ariq-dotcom/5dof-robotic-arm/README.md

# Robot Arm 5-DOF

Repository ini berisi file-file hasil Project Based Learning (PBL) pada mata kuliah Otomasi Industri, berupa pengembangan robot arm 5-DOF berbasis Arduino. Project ini mencakup desain assembly mekanikal, desain PCB, perhitungan serta visualisasi menggunakan Python, program kendali servo, dan beberapa dokumentasi pengembangan.

<p align="center">
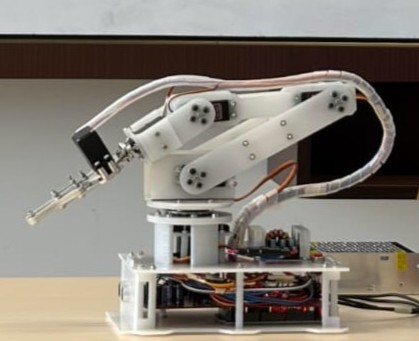
[picture p1: Dokumentasi/4.jpeg]
  
</p>

## File-File
### Mekanikal

desain assembly mekanikal robot arm

### Elektrikal

Perancangan sistem elektrikal, schematic, dan PCB menggunakan KiCad.

### Software

Perangkat lunak untuk perhitungan dan visualisasi invers kinematik robot arm menggunakan Python, serta program Arduino untuk pengendalian servo.

### Dokumentasi

Dokumentasi proses perakitan, perkembangan, dan demonstrasi robot arm.
