ariq-dotcom/5dof-robotic-arm/elektrikal/ARM ELEKTRIKAL.kicad_pcb

## KiCad design elektrikal/ARM ELEKTRIKAL.kicad_pcb (2026-08-11)

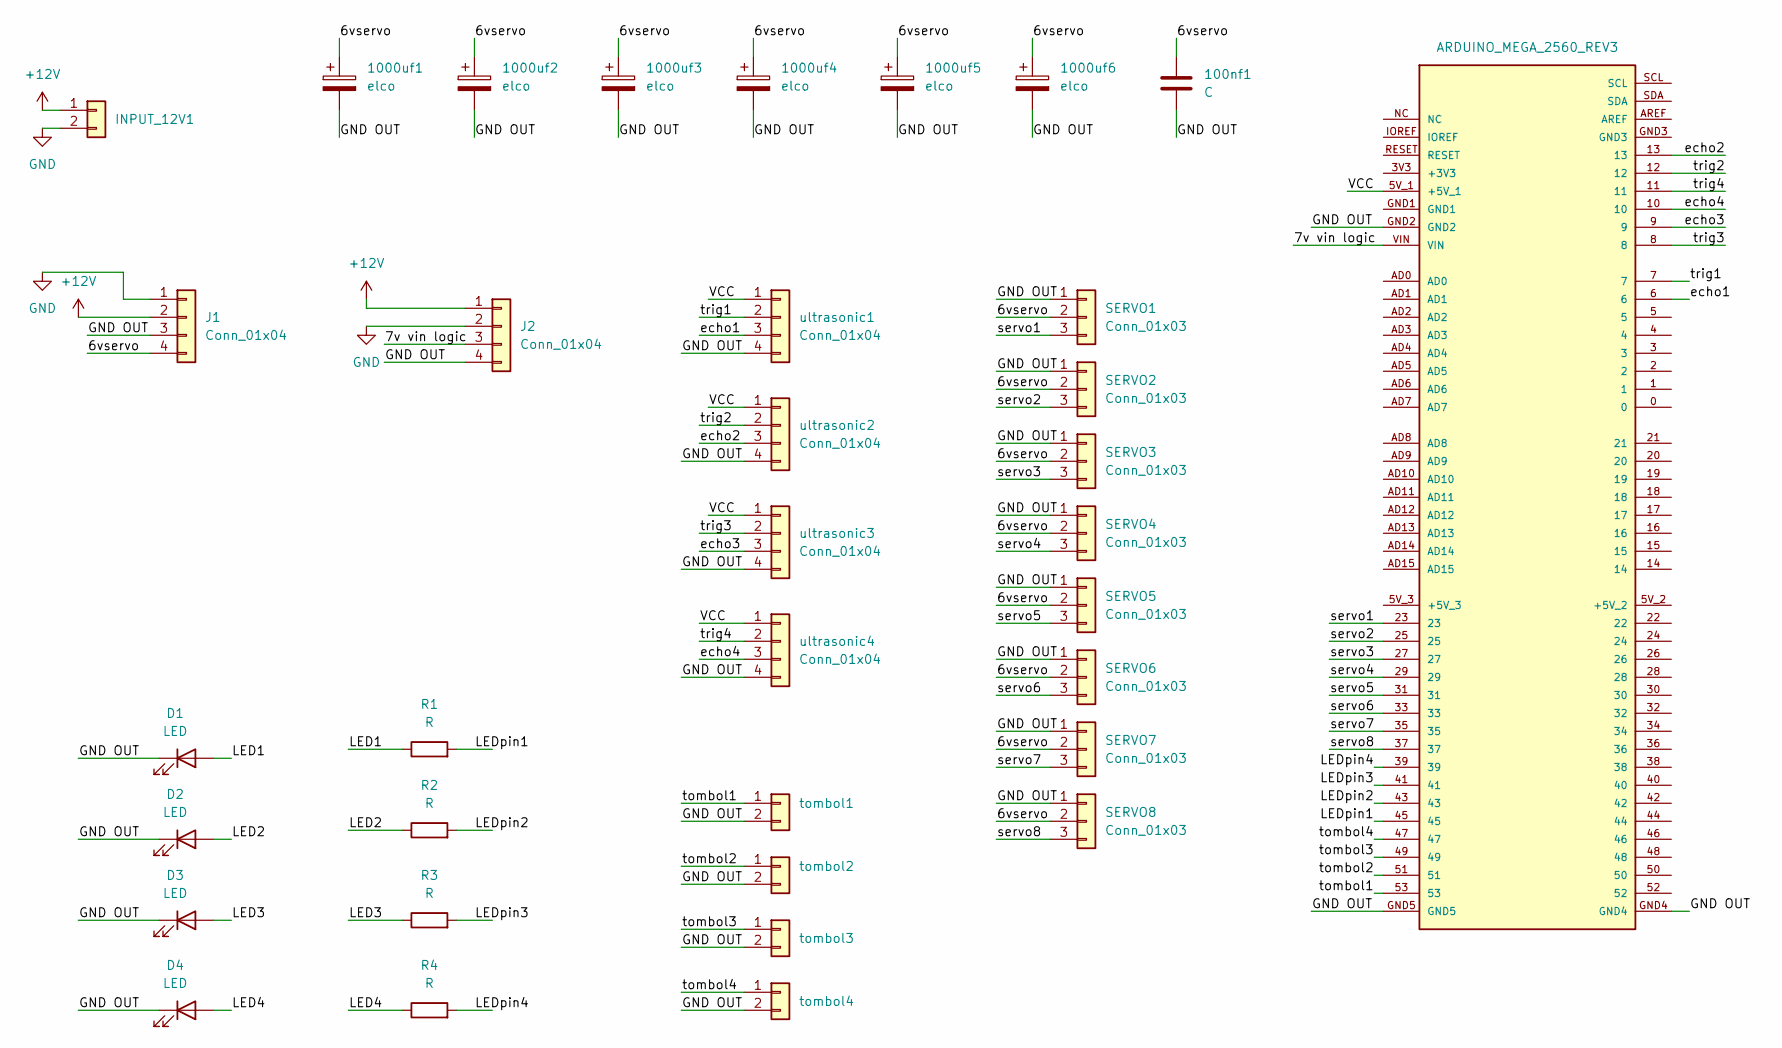
[picture p2: schematic ARM ELEKTRIKAL.kicad_sch]

Parts:
100nf1: C; C_Rect_L9.0mm_W2.7mm_P7.50mm_MKT
1000uf1, 1000uf2, 1000uf3, 1000uf4, 1000uf5, 1000uf6: elco; CP_Radial_D10.0mm_P5.00mm
A1: ARDUINO_MEGA_2560_REV3; ARDUINO_ARDUINO_MEGA_2560_REV3; PARTREV 3
D1, D2, D3, D4: LED; PinHeader_1x02_P2.54mm_Vertical
INPUT_12V1: Conn_01x02; TerminalBlock_MetzConnect_Type171_RT13702HBWC_1x02_P7.50mm_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
J1, J2: Conn_01x04; TerminalBlock_MetzConnect_Type171_RT13704HBWC_1x04_P7.50mm_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
R1, R2, R3, R4: R; R_Axial_DIN0204_L3.6mm_D1.6mm_P7.62mm_Horizontal
SERVO1, SERVO2, SERVO3, SERVO4, SERVO5, SERVO6, SERVO7, SERVO8: Conn_01x03; PinHeader_1x03_P2.54mm_Vertical
tombol1, tombol2, tombol3, tombol4: Conn_01x02; PinHeader_1x02_P2.54mm_Vertical
ultrasonic1, ultrasonic2, ultrasonic3, ultrasonic4: Conn_01x04; PinHeader_1x04_P2.54mm_Vertical

Connections:
+12V: INPUT_12V1.1, J1.2, J2.1
/6vservo: 100nf1.1, 1000uf1.1, 1000uf2.1, 1000uf3.1, 1000uf4.1, 1000uf5.1, 1000uf6.1, J1.4, SERVO1.2, SERVO2.2, SERVO3.2, SERVO4.2, SERVO5.2, SERVO6.2, SERVO7.2, SERVO8.2
/7v vin logic: A1.VIN, J2.3
/GND OUT: 100nf1.2, 1000uf1.2, 1000uf2.2, 1000uf3.2, 1000uf4.2, 1000uf5.2, 1000uf6.2, A1.GND2, A1.GND4, A1.GND5, D1.1 (K), D2.1 (K), D3.1 (K), D4.1 (K), J1.3, J2.4, SERVO1.1, SERVO2.1, SERVO3.1, SERVO4.1, SERVO5.1, SERVO6.1, SERVO7.1, SERVO8.1, tombol1.2, tombol2.2, tombol3.2, tombol4.2, ultrasonic1.4, ultrasonic2.4, ultrasonic3.4, ultrasonic4.4
/LED1: D1.2 (A), R1.1
/LED2: D2.2 (A), R2.1
/LED3: D3.2 (A), R3.1
/LED4: D4.2 (A), R4.1
/LEDpin1: A1.45, R1.2
/LEDpin2: A1.43, R2.2
/LEDpin3: A1.41, R3.2
/LEDpin4: A1.39, R4.2
/VCC: A1.5V_1 (+5V_1), ultrasonic1.1, ultrasonic2.1, ultrasonic3.1, ultrasonic4.1
/echo1: A1.6, ultrasonic1.3
/echo2: A1.13, ultrasonic2.3
/echo3: A1.9, ultrasonic3.3
/echo4: A1.10, ultrasonic4.3
/servo1: A1.23, SERVO1.3
/servo2: A1.25, SERVO2.3
/servo3: A1.27, SERVO3.3
/servo4: A1.29, SERVO4.3
/servo5: A1.31, SERVO5.3
/servo6: A1.33, SERVO6.3
/servo7: A1.35, SERVO7.3
/servo8: A1.37, SERVO8.3
/tombol1: A1.53, tombol1.1
/tombol2: A1.51, tombol2.1
/tombol3: A1.49, tombol3.1
/tombol4: A1.47, tombol4.1
/trig1: A1.7, ultrasonic1.2
/trig2: A1.12, ultrasonic2.2
/trig3: A1.8, ultrasonic3.2
/trig4: A1.11, ultrasonic4.2
GND: INPUT_12V1.2, J1.1, J2.2

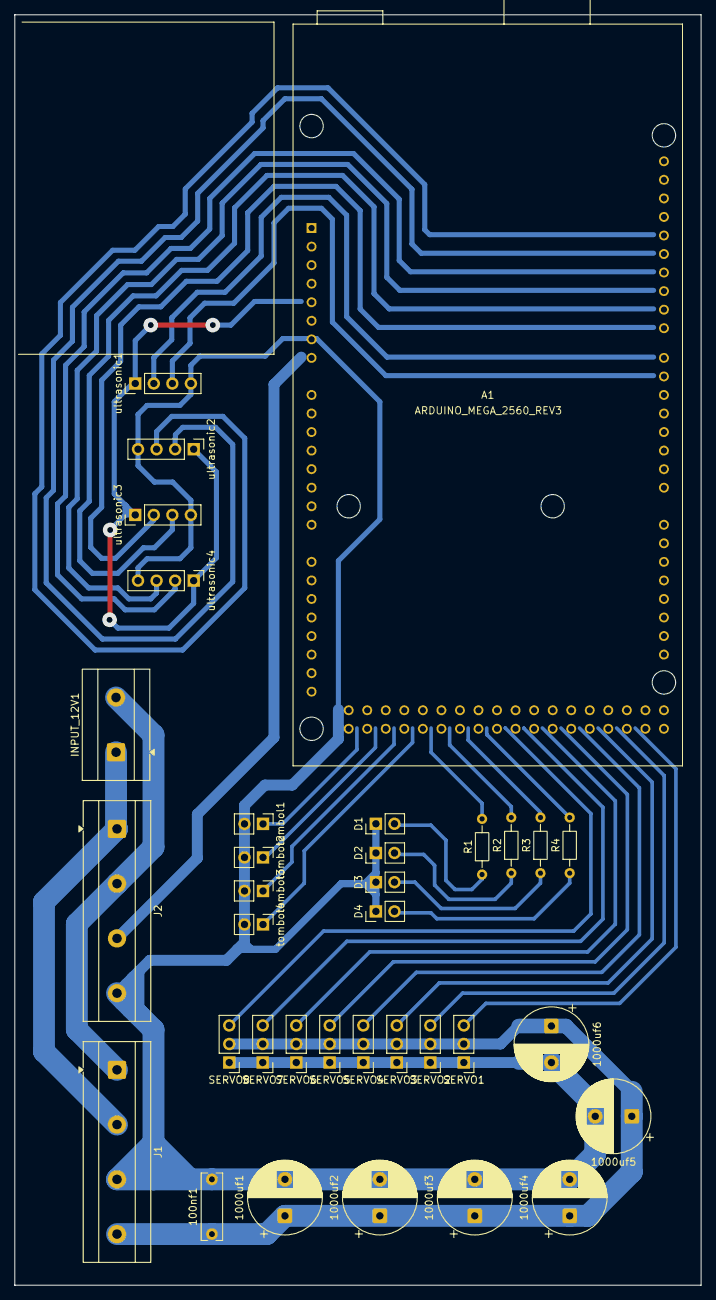
[picture p3: board ARM ELEKTRIKAL.kicad_pcb from above]

Board: 2 copper layers, 94.0 x 174.0 mm, 35 parts (0 on the bottom side), 34 nets.
