ariq-dotcom/5dof-robotic-arm/mekanikal/ASSEMBLY.png

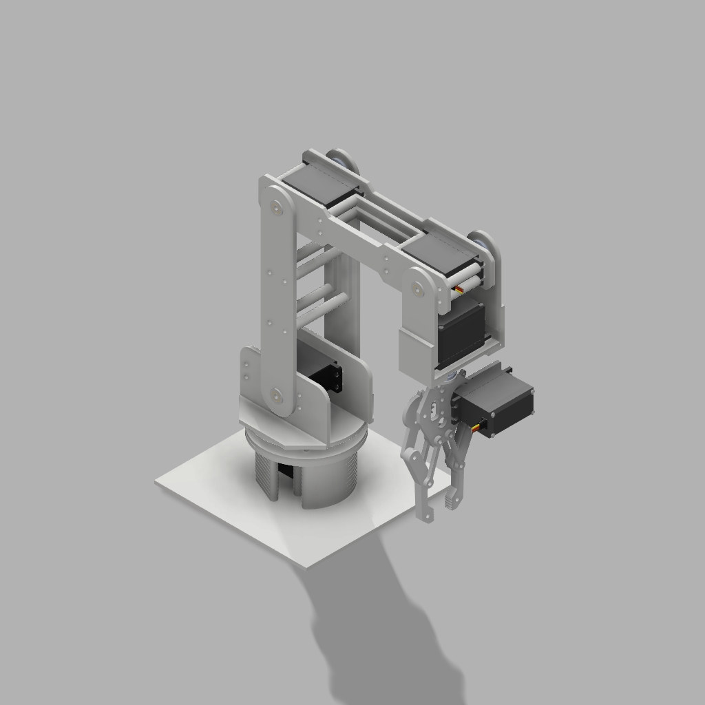
mekanikal/ASSEMBLY.png
