ariq-dotcom/5dof-robotic-arm/software/kendali/kendali.ino

//KELOMPOK 2 projek robot

// Ariq Suryaselpha Hamid
// Sofyan Adam Malik
// Noviana Rahmadhani
// Gilang Al Buqhori
// Wahyu Septian Wicahya


#include <Arduino.h>
#include <Servo.h>

#define pinHOME 53 // posisi awal
#define pinKERJA 51 // mode kerja
#define pinDEMO 49 // mode demonstrasi (beberapa gerakan kemampuan robot)

#define ledHOME 4
#define ledKERJA 3
#define ledDEMO 2

#define TRIG_PIN 12
#define ECHO_PIN 13

enum Mode {
  HOME,
  KERJA,
  DEMO
};

Mode modeSekarang = HOME;
Mode modeDiminta = HOME;

bool tugasSelesai = true;

//===============================================================================
//===============================================================================
//===============================================================================

//nama servo
Servo base;
Servo shoulder;
Servo elbow;
Servo wristP;
Servo wristR;
Servo gripper;

#include <math.h>
//dimensi robot
const float L1 = 7.9;
const float L2 = 15.0;
const float L3 = 13.0;
const float L4 = 7.3;
const float L5 = 11;

//untuk nilai sekarang juga penyimpanan nilai saat berjalan
float sekarang_s0 = 90;
float sekarang_s1 = 20;
float sekarang_s2 = 20;
float sekarang_s3 = 117;
float sekarang_s4 = 90;

//nilai sudut untuk ke posisi home
const float HOME_s0 = 90;
const float HOME_s1 = 20;
const float HOME_s2 = 20;
const float HOME_s3 = 117;
const float HOME_s4 = 90;

// ===== PROTOTIPE FUNGSI =====
bool ik_task(float x, float y, float z_target, float phi_deg,
                      float *t0_deg, float *t1_deg, float *t2_deg, 
                      float *t3_deg, float *t4_deg);

float keServo(float sudut);

void mapkeServo(float t0, float t1, float t2, float t3, float t4,
                float *s0, float *s1, float *s2, float *s3, float *s4);

void gerakKe(float x, float y, float z, float phi, int stepDelay);

void gerakServo(float s0, float s1, float s2,
                float s3, float s4, int stepDelay);

void bacaTombol();

void updateLED();

void gerakHome();

float bacaJarak();

bool tunggu(unsigned long waktu);

//MMMMMMMMMMMMMMMMMMMMMMMMMMMMMMMMMMMMMMMMMMMMMMMMMMMMMMMMMMMMMMMM
//MMMMMMMMMMMMMMMMMMMMMMMMMMMMMMMMMMMMMMMMMMMMMMMMMMMMMMMMMMMMMMMM
void setup() {
  Serial.begin(115200);

  pinMode(pinHOME, INPUT_PULLUP);
  pinMode(pinKERJA, INPUT_PULLUP);
  pinMode(pinDEMO, INPUT_PULLUP);

  pinMode(TRIG_PIN, OUTPUT);
  pinMode(ECHO_PIN, INPUT);

  pinMode(ledHOME, OUTPUT);
  pinMode(ledKERJA, OUTPUT);
  pinMode(ledDEMO, OUTPUT);

  base.attach(23);
  shoulder.attach(31);
  elbow.attach(29);
  wristP.attach(35);
  wristR.attach(33);
  gripper.attach(25);

  base.write((int)sekarang_s0);
  shoulder.write((int)sekarang_s1);
  elbow.write((int)sekarang_s2);
  wristP.write((int)sekarang_s3);
  wristR.write((int)sekarang_s4);

  // ===== CETAK KE SERIAL (untuk monitor) =====
    Serial.print("Base: "); Serial.print((int)sekarang_s0);
    Serial.print(" | Shoulder: "); Serial.print((int)sekarang_s1);
    Serial.print(" | Elbow: "); Serial.print((int)sekarang_s2);
    Serial.print(" | WristP: "); Serial.print((int)sekarang_s3);
    Serial.print(" | WristR: "); Serial.println((int)sekarang_s4);

  delay(5000);
  updateLED();
}
//MMMMMMMMMMMMMMMMMMMMMMMMMMMMMMMMMMMMMMMMMMMMMMMMMMMMMMMMMMMMMMMM
//MMMMMMMMMMMMMMMMMMMMMMMMMMMMMMMMMMMMMMMMMMMMMMMMMMMMMMMMMMMMMMMM

//################################################################
//################################################################
void loop() {

  bacaTombol();

  // Menjalankan mode yang aktif
  switch (modeSekarang) {

//############################
//========== HOME ===========
    case HOME: {
      // Program home
      if (sekarang_s0 != HOME_s0 ||
      sekarang_s1 != HOME_s1 ||
      sekarang_s2 != HOME_s2 ||
      sekarang_s3 != HOME_s3 ||
      sekarang_s4 != HOME_s4) {
      tugasSelesai = false;
      if (!tunggu(100))
    break;
      gripper.write(95);
      gerakHome();
      tugasSelesai = true;
      }
      break;
    }
//============================
//############################
//========== KERJA ===========

    case KERJA: {
      // Program kerja
      tugasSelesai = false;

      float jarak = bacaJarak();

      if (!tunggu(100))
    break;
  
      // x,y,z,phi,delayStep
      gerakKe(-0.7, 10, 0, -90, 7);
      Serial.print("Jarak: ");
      Serial.print(jarak);
      Serial.println(" cm");
      if (jarak > 0 && jarak < 13) {
        Serial.println("Objek Terdeteksi");
        gripper.write(25);

        jarak = bacaJarak();
        Serial.println(jarak);
        if (!tunggu(1000))
      break;
        jarak = bacaJarak();
        Serial.println(jarak);
        if (!tunggu(1000))
      break;
        jarak = bacaJarak();
        Serial.println(jarak);
        if (!tunggu(1000))
      break;

        //+8 cm adalah jarak awal persis depan sensor, 
        //dihitung dari titik pusat invers kinematik ke sensor
        //lalu + setelahnya untuk offset seberapa panjang lebar objek yang diambil
        //menyesuaikan agar posisi capitan pas
        
        gerakKe(-0.7, 8+jarak +1, 0, -90, 7);
        if (!tunggu(1000))
      break;
        gerakKe(-0.7, 8+jarak +1, -5, -90, 7);
        if (!tunggu(1000))
      break;
        gripper.write(95);
        if (!tunggu(1000))
      break;
        gerakKe(-0.7, 8+jarak +1, 0, -90, 7);
        if (!tunggu(1000))
      break;

      // ==== lanjutan ====
        gerakKe(-13, 0, 0, -90, 7);
        if (!tunggu(1000))
      break;
        gerakKe(-13, 0, -5, -90, 7);
        if (!tunggu(1000))
      break;
        gripper.write(25);
        if (!tunggu(2000))
      break;
        gerakKe(-13, 7, -5, -90, 10);
        if (!tunggu(500))
      break;

      }

      tugasSelesai = true;
      break;
    }
//============================
//############################
//========== DEMO ===========
    case DEMO: {
      // Program demo
      tugasSelesai = false;

      // x,y,z,phi,delayStep
      gerakKe(0, 15, 0, -90, 7);
      if (!tunggu(2000))
    break;
      gripper.write(25);
      if (!tunggu(1000))
    break;
      gerakKe(0, 15, 0, -90, 7);
      if (!tunggu(1000))
    break;
      gerakKe(0, 15, -5, -90, 7);
      gripper.write(95);
      if (!tunggu(1000))
    break;

      gerakKe(0, 15, 0, -90, 7);
      if (!tunggu(1000))
    break;
      gerakKe(15, 0, 0, -90, 7);
      if (!tunggu(1000))
    break;
      gerakKe(15, 0, -5, -90, 7);
      if (!tunggu(1000))
    break;
      gripper.write(25);
      if (!tunggu(1000))
    break;
      gripper.write(95);
      if (!tunggu(1000))
    break;
      gerakKe(15, 0, 0, -90, 7);
      if (!tunggu(1000))
    break;

      gerakKe(-15, 0, 0, -90, 7);
      if (!tunggu(1000))
    break;
      gerakKe(-15, 0, -5, -90, 7);
      if (!tunggu(1000))
    break;
      gripper.write(25);
      if (!tunggu(1000))
    break;
      gripper.write(95);
      if (!tunggu(1000))
    break;
      gerakKe(-15, 0, 0, -90, 7);
      if (!tunggu(1000))
    break;

      tugasSelesai = true;
      break;
    }
  }
//============================
//############################

    if (tugasSelesai && modeDiminta != modeSekarang) {
      modeSekarang = modeDiminta;
      updateLED();
      Serial.print("Pindah ke mode : ");

      switch (modeSekarang) {

        case HOME:
          Serial.println("HOME");
          break;

        case KERJA:
          Serial.println("KERJA");
          break;

        case DEMO:
          Serial.println("DEMO");
          break;
      }
    }
}
//################################################################
//################################################################

//################################################################
// FUNGSI IK, FUNGSI IK, FUNGSI IK
//################################################################

// ==== FUNGSI IK ====
bool ik_task(float x, float y, float z_target, float phi_deg,
                      float *t0_deg, float *t1_deg, float *t2_deg, 
                      float *t3_deg, float *t4_deg) {
  
  // ===== Base rotation =====
  float theta0 = atan2(y, x);
  float theta0_deg = theta0 * 180.0 / PI;
  
  // ===== Wrist rotation =====
  // menjaga agar gripper menyesuaikan arah base
  float theta4_deg = theta0_deg;
  
  // ===== Transformasi ke plane =====
  float x_plane_tcp = x * cos(theta0) + y * sin(theta0);
  float y_plane_tcp = z_target - L1;

  // ===== Tool offset =====
  float L_tool = L4 + L5;
  float phi = phi_deg * PI / 180.0;  // konversi ke radian
  
  float x_plane = x_plane_tcp - L_tool * cos(phi);
  float y_plane = y_plane_tcp - L_tool * sin(phi);
  
  // ===== Jarak ke shoulder =====
  float r = sqrt(x_plane * x_plane + y_plane * y_plane);

  // ===== Cek workspace =====
  if (r > (L2 + L3) || r < fabs(L2 - L3))
  {
    Serial.print("Target di luar workspace : ");
    Serial.print(x);
    Serial.print(", ");
    Serial.print(y);
    Serial.print(", ");
    Serial.println(z_target);  

    return false;
  }
  
  // ===== Elbow-up solution =====
  float cos_theta2 = (x_plane*x_plane + y_plane*y_plane - L2*L2 - L3*L3) / (2.0 * L2 * L3);
  cos_theta2 = constrain(cos_theta2, -1.0, 1.0);
  float theta2 = -acos(cos_theta2);
  
  float k1 = L2 + L3 * cos(theta2);
  float k2 = L3 * sin(theta2);

  float theta1 = atan2(y_plane, x_plane) - atan2(k2, k1);
  
  // ===== Wrist pitch =====
  float theta3 = phi - (theta1 + theta2);
  
  // ===== Konversi ke derajat =====
  float theta1_deg = theta1 * 180.0 / PI;
  float theta2_deg = theta2 * 180.0 / PI;
  float theta3_deg = theta3 * 180.0 / PI;

  // ===== KEMBALIKAN HASIL via pointer =====
  *t0_deg = theta0_deg;
  *t1_deg = theta1_deg;
  *t2_deg = theta2_deg;
  *t3_deg = theta3_deg;
  *t4_deg = theta4_deg;

  return true;
}
//################################################################
//################################################################

//MMMMMMMMMMMMMMMMMMMMMMMMMMMMMMMMMMMMMMMMMMMMMMMMMMMMMMMMMMMMMMMM
// FUNGSI MAPPING DAN CLAMP
//MMMMMMMMMMMMMMMMMMMMMMMMMMMMMMMMMMMMMMMMMMMMMMMMMMMMMMMMMMMMMMMM

//==== CLAMP ====
float keServo(float sudut) {
  if (sudut < 0) return 0;
  if (sudut > 180) return 180;
  return sudut;
}

//==== MAPPING ====
void mapkeServo(float t0, float t1, float t2, float t3, float t4,
                float *s0, float *s1, float *s2, float *s3, float *s4) {
  // =======================================
  // KOREKSI MEKANIK (Hasil perhitungan matematis disesuaikan 
  // dengan kalibrasi pemasangan servo)
  // =======================================
  *s0 = t0;
  *s1 = 180 - t1;
  *s2 = t2 + 180;
  *s3 = 180 - (t3 + 90);
  *s4 = t4;
  // ============
  // CLAMP 0–180
  // ============
  *s0 = keServo(*s0);
  *s1 = keServo(*s1);
  *s2 = keServo(*s2);
  *s3 = keServo(*s3);
  *s4 = keServo(*s4);
}
//MMMMMMMMMMMMMMMMMMMMMMMMMMMMMMMMMMMMMMMMMMMMMMMMMMMMMMMMMMMMMMMM
//MMMMMMMMMMMMMMMMMMMMMMMMMMMMMMMMMMMMMMMMMMMMMMMMMMMMMMMMMMMMMMMM

//################################################################
//FUNGSI GERAKAN HALUS
//################################################################
void gerakKe(float x, float y, float z, float phi, int stepDelay) {

  // ===== TARGET IK =====
  float t0, t1, t2, t3, t4;

  // ===== TARGET SERVO =====
  float s0, s1, s2, s3, s4;

  // ===== IK =====
  if (!ik_task(x, y, z, phi,
          &t0, &t1, &t2, &t3, &t4))
  {
    return;
  }

  // ===== MAPPING =====
  mapkeServo(t0, t1, t2, t3, t4,
             &s0, &s1, &s2, &s3, &s4);

  gerakServo(s0, s1, s2, s3, s4, stepDelay);
}
//################################################################
//################################################################

//################################################################
// FUNGSI BACA TOMBOL
//################################################################
void bacaTombol() {

  static unsigned long lastDebounce = 0;

  if (millis() - lastDebounce < 200)
    return;

  if (digitalRead(pinHOME) == LOW &&
      modeSekarang != HOME) {

    modeDiminta = HOME;
    Serial.println("Mode HOME diminta");
    lastDebounce = millis();
  }

  else if (digitalRead(pinKERJA) == LOW &&
           modeSekarang != KERJA) {

    modeDiminta = KERJA;
    Serial.println("Mode KERJA diminta");
    lastDebounce = millis();
  }

  else if (digitalRead(pinDEMO) == LOW &&
           modeSekarang != DEMO) {

    modeDiminta = DEMO;
    Serial.println("Mode DEMO diminta");
    lastDebounce = millis();
  }
}
//################################################################
//################################################################

//################################################################
// FUNGSI GERAK, LINEAR INTERPOLATION
//################################################################
void gerakServo(float s0, float s1, float s2,
                float s3, float s4, int stepDelay)
{
  float start_s0 = sekarang_s0;
  float start_s1 = sekarang_s1;
  float start_s2 = sekarang_s2;
  float start_s3 = sekarang_s3;
  float start_s4 = sekarang_s4;

  float d0 = fabs(s0 - start_s0);
  float d1 = fabs(s1 - start_s1);
  float d2 = fabs(s2 - start_s2);
  float d3 = fabs(s3 - start_s3);
  float d4 = fabs(s4 - start_s4);

  float maxDelta = d0;

  if (d1 > maxDelta) maxDelta = d1;
  if (d2 > maxDelta) maxDelta = d2;
  if (d3 > maxDelta) maxDelta = d3;
  if (d4 > maxDelta) maxDelta = d4;

  int steps = (int)maxDelta;

  if (steps < 1)
    steps = 1;

  for (int i = 1; i <= steps; i++) {

    float p = (float) i / steps;

    sekarang_s0 = start_s0 + (s0 - start_s0) * p;
    sekarang_s1 = start_s1 + (s1 - start_s1) * p;
    sekarang_s2 = start_s2 + (s2 - start_s2) * p;
    sekarang_s3 = start_s3 + (s3 - start_s3) * p;
    sekarang_s4 = start_s4 + (s4 - start_s4) * p;
    
    bacaTombol();

    if (modeDiminta != modeSekarang)
        return;
      
    base.write((int)sekarang_s0);
    shoulder.write((int)sekarang_s1);
    elbow.write((int)sekarang_s2);
    wristP.write((int)sekarang_s3);
    wristR.write((int)sekarang_s4);

    Serial.print("Base: "); Serial.print((int)sekarang_s0);
    Serial.print(" | Shoulder: "); Serial.print((int)sekarang_s1);
    Serial.print(" | Elbow: "); Serial.print((int)sekarang_s2);
    Serial.print(" | WristP: "); Serial.print((int)sekarang_s3);
    Serial.print(" | WristR: "); Serial.println((int)sekarang_s4);

    delay(stepDelay);
  }

  sekarang_s0 = s0;
  sekarang_s1 = s1;
  sekarang_s2 = s2;
  sekarang_s3 = s3;
  sekarang_s4 = s4;
}
//################################################################
//################################################################

//################################################################
// FUNGSI UPDATE LED
//################################################################
void updateLED() {

  digitalWrite(ledHOME, modeSekarang == HOME);
  digitalWrite(ledKERJA, modeSekarang == KERJA);
  digitalWrite(ledDEMO, modeSekarang == DEMO);
}
//################################################################
//################################################################

//################################################################
// FUNGSI KEMBALI KE POSISI HOME
//################################################################
void gerakHome()
{
    gerakServo(
        HOME_s0,
        HOME_s1,
        HOME_s2,
        HOME_s3,
        HOME_s4,
        7
    );
}
//################################################################
//################################################################

//################################################################
// FUNGSI BACA JARAK
//################################################################
float bacaJarak() {
  digitalWrite(TRIG_PIN, LOW);
  delayMicroseconds(2);

  digitalWrite(TRIG_PIN, HIGH);
  delayMicroseconds(10);

  digitalWrite(TRIG_PIN, LOW);

  long durasi = pulseIn(ECHO_PIN, HIGH, 30000);

  if (durasi == 0) {
    return -1;
  }

  float jarak = durasi * 0.034 / 2.0;

  return jarak;
}
//################################################################
//################################################################

//################################################################
// FUNGSI TUNGGU, PENGGANTI DELAY AGAR RESPONSIF
//################################################################
bool tunggu(unsigned long waktu)
{
    unsigned long mulai = millis();

    while (millis() - mulai < waktu)
    {
        bacaTombol();

        if (modeDiminta != modeSekarang)
        {
            tugasSelesai = true;
            return false;
        }
    }
    return true;
}
//################################################################
//################################################################

//===============================================================================
//===============================================================================
//===============================================================================
